prishit22/FPGA-TDR-Fault-Detection/TDR_Project_Images/page_08_image_01.jpeg

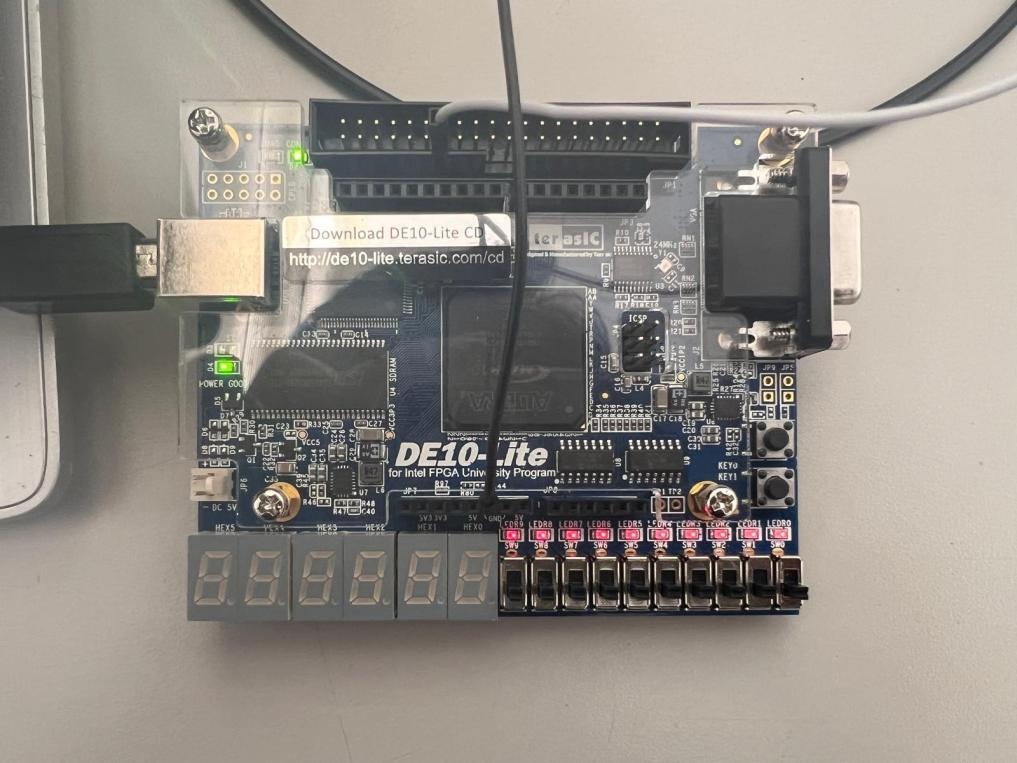
TDR_Project_Images/page_08_image_01.jpeg
