prishit22/FPGA-TDR-Fault-Detection/TDR_Project_Images/page_15_image_01.png

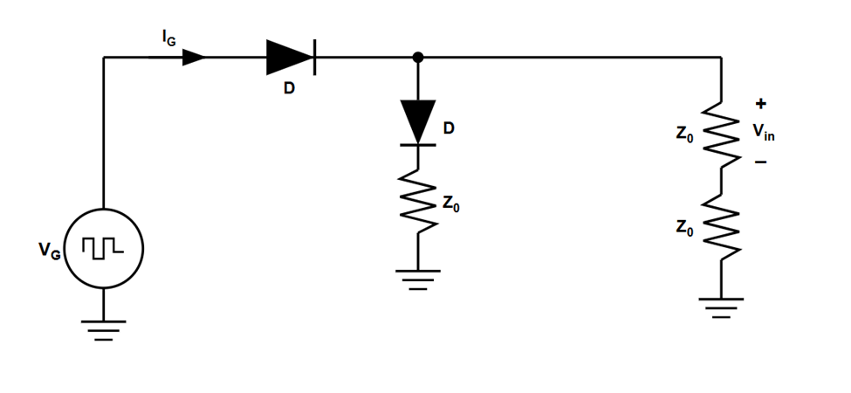
TDR_Project_Images/page_15_image_01.png
