prishit22/FPGA-TDR-Fault-Detection/TDR_Project_Images/page_22_image_01.png

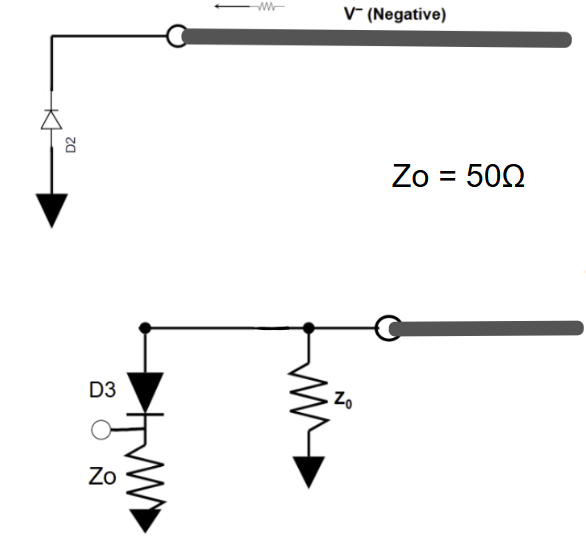
TDR_Project_Images/page_22_image_01.png
