prishit22/FPGA-TDR-Fault-Detection/TDR_Project_Images/page_50_image_02.jpeg

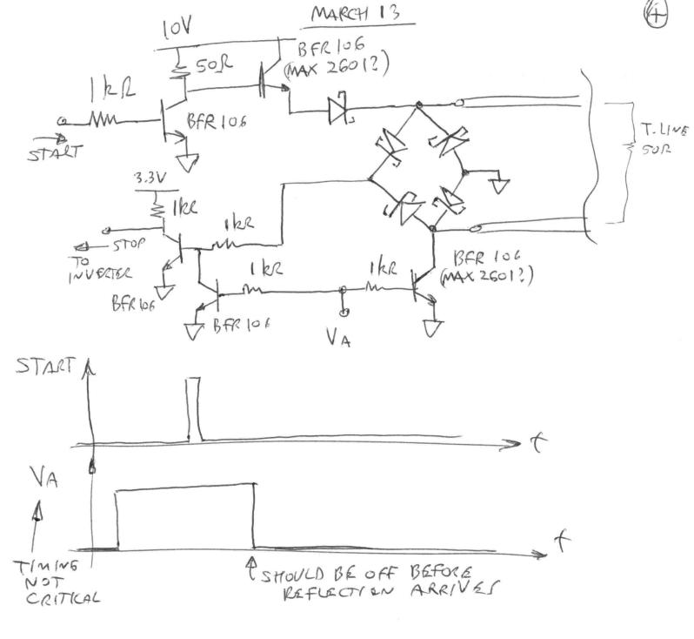
TDR_Project_Images/page_50_image_02.jpeg
