prishit22/FPGA-TDR-Fault-Detection/TDR_Project_Images/page_53_image_02.png

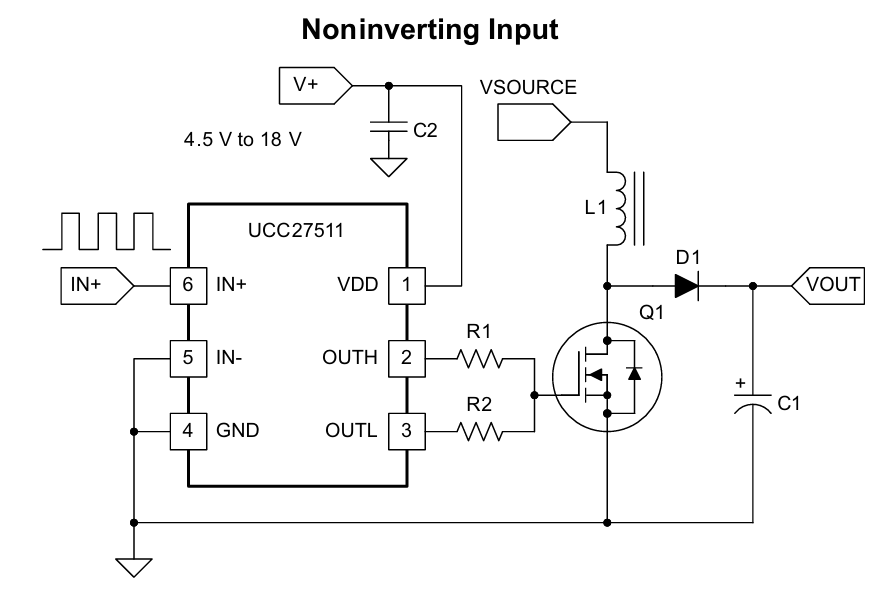
TDR_Project_Images/page_53_image_02.png
